agus-espinola-unlz/2026_2C_PF_VEHICULO-AUTONOMO-MARCADO-DE-LAYOUTS_ESPINOLA-SULLCA/Informes/Gantt Vehículo Autónomo.xlsx

Sheet: Diagrama de Gantt
Vehículo Autónomo para marcado de Layout |  |  |  |  |  |  |  | Fecha de inicio: |  |  |  |  |  |  |  | 2026-08-10
Espinola - Sullca | Lideres de proyecto |  |  |  |  |  |  | Semana: |  |  |  |  |  |  |  | 1
 |  |  |  |  |  |  |  | 2026-08-10 |  |  |  |  |  |  | 2026-08-17 |  |  |  |  |  |  | 2026-08-24 |  |  |  |  |  |  | 2026-08-31 |  |  |  |  |  |  | 2026-09-07 |  |  |  |  |  |  | 2026-09-14 |  |  |  |  |  |  | 2026-09-21 |  |  |  |  |  |  | 2026-09-28
TAREA | RESPONSABLE | PROGRESO | INICIO | DIAS | FINAL | HORAS ESTIMADAS | HORAS REALES | 2026-08-10 | 2026-08-11 | 2026-08-12 | 2026-08-13 | 2026-08-14 | 2026-08-15 | 2026-08-16 | 2026-08-17 | 2026-08-18 | 2026-08-19 | 2026-08-20 | 2026-08-21 | 2026-08-22 | 2026-08-23 | 2026-08-24 | 2026-08-25 | 2026-08-26 | 2026-08-27 | 2026-08-28 | 2026-08-29 | 2026-08-30 | 2026-08-31 | 2026-09-01 | 2026-09-02 | 2026-09-03 | 2026-09-04 | 2026-09-05 | 2026-09-06 | 2026-09-07 | 2026-09-08 | 2026-09-09 | 2026-09-10 | 2026-09-11 | 2026-09-12 | 2026-09-13 | 2026-09-14 | 2026-09-15 | 2026-09-16 | 2026-09-17 | 2026-09-18 | 2026-09-19 | 2026-09-20 | 2026-09-21 | 2026-09-22 | 2026-09-23 | 2026-09-24 | 2026-09-25 | 2026-09-26 | 2026-09-27 | 2026-09-28
 |  |  |  |  |  |  |  | l | m | m | j | v | s | d | l | m | m | j | v | s | d | l | m | m | j | v | s | d | l | m | m | j | v | s | d | l | m | m | j | v | s | d | l | m | m | j | v | s | d | l | m | m | j | v | s | d | l
Chasis
Calculo de torque y selección de motores | Agustin | 100% | 2026-08-10 | 2 | 2026-08-12 | 2 | 2
Diseño y montaje de chasis | Marco | 60% | 2026-08-12 | 40 | 2026-09-21 | 20 | 8
Navegación y ubicación
Programación Apriltags | Agustin | 50% | 2026-09-01 | 7 | 2026-09-08 | 12 | 6
Programación de movimiento (encoders + apriltag) | Agustin / Marco | 50% | 2026-09-01 | 40 | 2026-10-11 | 30 | 12
Control de calidad | Agustin | 15% | 2026-08-31 | 14 | 2026-09-14 | 12 | 4
Control de trayectorias
Implementación de Control PID | Marco | 0% | 2026-09-20 | 14 | 2026-10-04 | 12
Interfaz
Conexión PC / ESP32 por WIFI | Agustin | 100% | 2026-08-19 | 5 | 2026-08-24 | 4 | 4
Convertir CAD a coordenadas | Agustin | 100% | 2026-08-19 | 5 | 2026-08-24 | 4 | 4
1ra Presentación (motores manual, encoders, software preliminar) |  | 100% | 2026-09-28 | 0 | 2026-09-28
Sistema de marcado
Bomba de tinta (montaje, conexión) | Marco | 0% | 2026-10-16 | 2 | 2026-10-18 | 4
Diseño de tanque de tinta | Marco | 0% | 2026-10-19 | 3 | 2026-10-22 | 4
Probar boquillas y tintas | Marco | 0% | 2026-10-23 | 3 | 2026-10-26 | 4
Ensayos
60% funcionando (movimiento auto, Apriltags, software avanzado) |  |  | 2026-10-26 | 0 | 2026-10-26
Pruebas y correciones | Agustin / Marco | 0% | 2026-10-25 | 15 | 2026-11-09
Presentación
Preparar documentación | Marco | 0% | 2026-11-10 | 5 | 2026-11-15 | 4 | 1
Preparar presentación | Agustin | 0% | 2026-11-10 | 5 | 2026-11-15 | 6
Presentación final |  |  | 2026-11-16 | 0 | 2026-11-16

Sheet: Registro de horas
Alumno | Tarea | Horas estimadas | Horas reales | Diferencia
Espinola Agustin | Definición de requerimientos y cálculo preliminar de componentes |  |  | 0
 | Diseño de interfaz y conexión |  |  | 0
 | Apriltag |  |  | 0
 | Programación movimiento |  |  | 0
 |  |  |  | 0
 |  |  |  | 0
 |  |  |  | 0
 |  |  |  | 0
 |  |  |  | 0
 |  |  |  | 0
Sullca Marco |  |  |  | 0
 |  |  |  | 0
 |  |  |  | 0
 |  |  |  | 0
 |  |  |  | 0
 |  |  |  | 0
 |  |  |  | 0
 |  |  |  | 0
 |  |  |  | 0
 |  |  |  | 0
 |  |  |  | 0

Sheet: Listado de Componentes
LISTADO DE COMPONENTES
Nombre | Descripción | Cantidad | Proveedor | Precio unitario | Total
ESP32 | Microcontrolador | 1 | Mercado Libre | $13000 | $13000
ESP32 CAM | Microcontrolador | 1 | Mercado Libre | $13000 | $13000
JGA25- 370 50RPM | Motor 12V DC | 2 | Mercado Libre | $40000 | $80000
L298N | Driver de motor | 1 | Mercado Libre | $5000 | $5000
AS5600 | Encoder Magnético | 2 | Mercado Libre | $5500 | $11000
MPU6050 | Giroscopio + Acelerometro | 1 | Mercado Libre | $6000 | $6000
HC-SR04 | Sensor Ultrasónico | 2 | Mercado Libre | $3000 | $6000
TCA9548A | Expansor I2C | 1 | Mercado Libre | $13000 | $13000
LM2596 | Regulador de voltaje | 1 | Mercado Libre | $6000 | $6000
Bateria 18650 - 3.7V 2500mAh | Baterias 12V | 3 | Mercado Libre | $11000 | $33000
Portabaterias para 3 18650 | Portabaterias | 1 | Mercado Libre | $5000 | $5000
BMS para 3 baterias 18650 | Módulo de protección para baterias | 1 | Mercado Libre | $5000 | $5000
TP4056 | Módulo de carga de baterias | 3 | Mercado Libre | $2300 | $6900
ISD1820 | Buzzer | 1 | Mercado Libre | $5000 | $5000
Led / Baliza | Leds colores varios | 5 | Mercado Libre | $2000 | $10000
Interruptor de dos posiciones | Llave para ON / OFF | 1 | Mercado Libre | $3000 | $3000
Tinta | Tinta de impresora 100ml | 1 | Mercado Libre | $15000 | $15000
Bomba peristaltica | Bomba persitaltica | 1 | Mercado Libre | $40000 | $40000
Cables dupont | Cables dupont de 20cm | 40 | Mercado Libre | $7000 | $7000
Borneras |  |  | Mercado Libre
Filamento | Chasis, ruedas, etc. |  | Mercado Libre
Total |  |  |  | $ARS | $282900
 |  |  |  | $USD | $180.19
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
