agus-espinola-unlz/2026_2C_PF_VEHICULO-AUTONOMO-MARCADO-DE-LAYOUTS_ESPINOLA-SULLCA/(commit log)

2026-08-31 Se suben Gantt y Propuesta Final Actualizados
    [Gantt Vehículo Autónomo.xlsx]
2026-08-31 Se actualiza Gantt
    [Gantt Vehículo Autónomo.xlsx]
2026-09-04 se suben inicios del control de calidad
2026-09-18 Archivos para calibración de espcam
2026-09-18 Etapa 2 de vision
2026-10-01 Se agrega codigo para linea de 5mm, altura de cámara 15cm, tolerancia 5%
    [Gantt Vehículo Autónomo.xlsx]
2026-10-07 Se eliminan las versiones viejas de código y se agregan las nuevas
2026-10-08 Código de Interfaz con QC
2026-11-02 V4: Detección automatica de IPs, Avance informes
